Charlox29/Beetter/website/img/installation_2.png

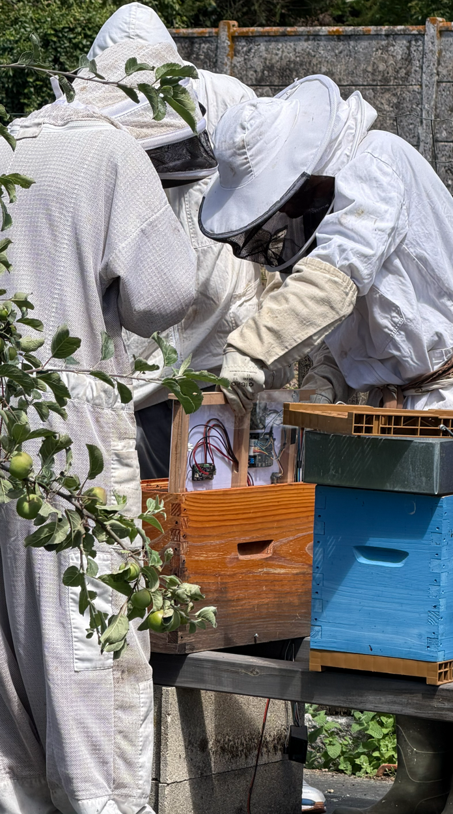
website/img/installation_2.png
