Charlox29/Beetter/website/img/installation_1.png

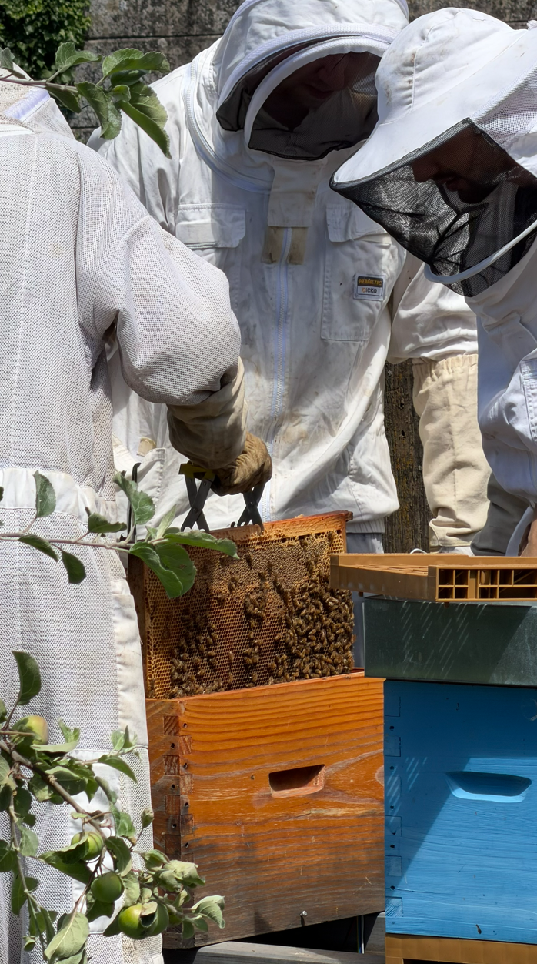
website/img/installation_1.png
