Charlox29/Beetter/website/docs/JDP_Affiche_Beetter_2026.pdf

– Une analyse interne et externe de la température, de l’hygrométrie, de la luminosité et de l’environnement sonore
– Un traitement intelligent des données grâce à différents modèles d’IA
– Une transmission longue distance
– Un stockage des données sur plusieurs mois/années
– Un système autonome en énergie

… donc voici notre solution.

# Système de Surveillance Apicole connecté

– La pollinisation assure 35 % du volume de la production agricole mondial
– La consommation mondiale de miel est de 1,8 à 2 millions de tonnes par an, se substituant aux sources de sucres classiques plus polluantes
– Une bonne pollinisation peut augmenter le nombre de fruits de 20 à 40 %, et permet de réduire de 25 % la quantité de fruits déformés

### Nos abeilles sont essentielles …

### Beetter Hive

– Le frelon asiatique les attaque
– Le décalage des saisons les perturbe
– Les événements météorologiques extrêmes comme les sécheresses prolongées
– Les visites physiques : Chaque ouverture de la ruche par l'apiculteur fait chuter la température interne, déchire la propolis et génère un stress thermique

### … mais elles sont en danger …

# Notre site

### Beetter Home

Promo E3 | AGUEH Thibault - AUCOUTURIER Charles - AZZA Anthony BERDUGO Simon - BOURGOIS Ethan

Suiveur :
FRANÇAIS Olivier
