Charlox29/Beetter/website/img/dash1en.png

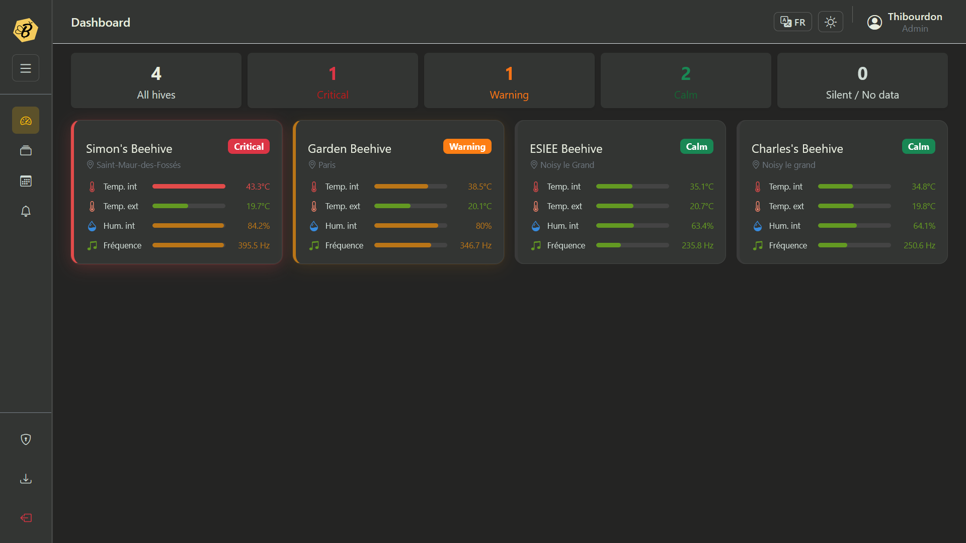
website/img/dash1en.png
