Charlox29/Beetter/website/img/dash1fr.png

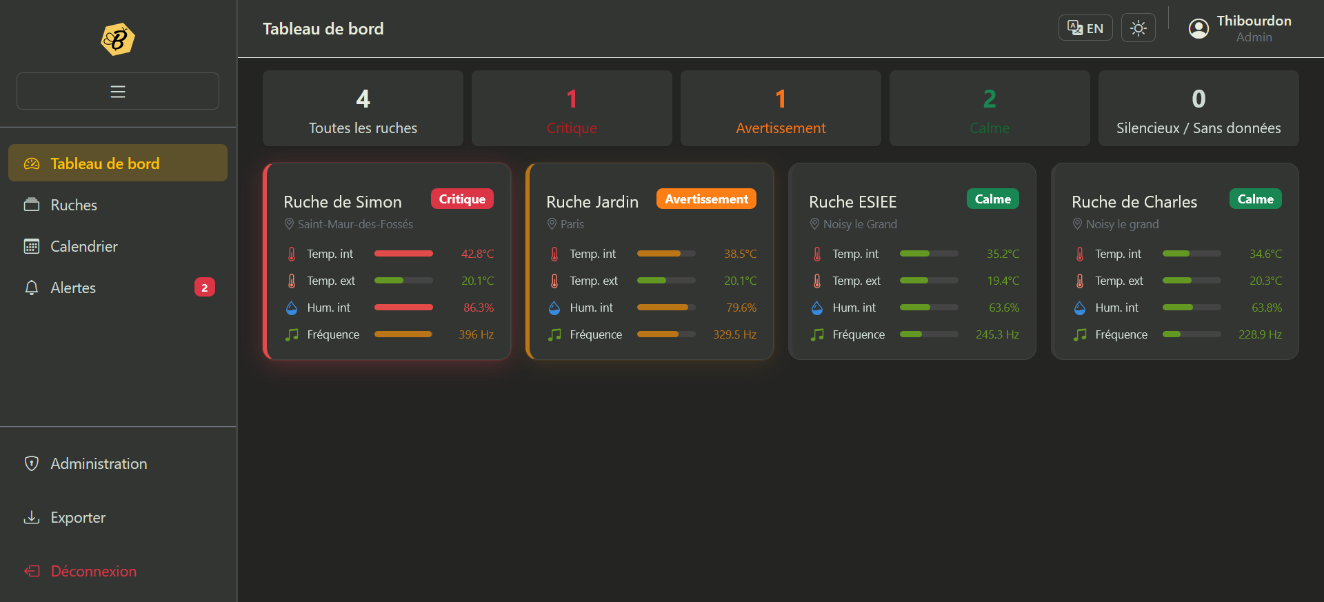
website/img/dash1fr.png
