Charlox29/Beetter/website/img/dash2en.png

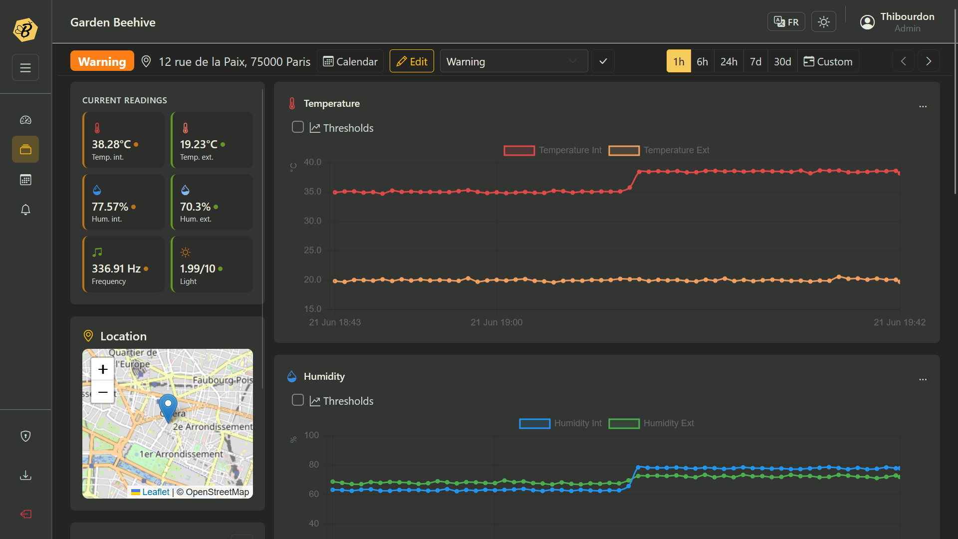
website/img/dash2en.png
