Charlox29/Beetter/website/img/dash2fr.png

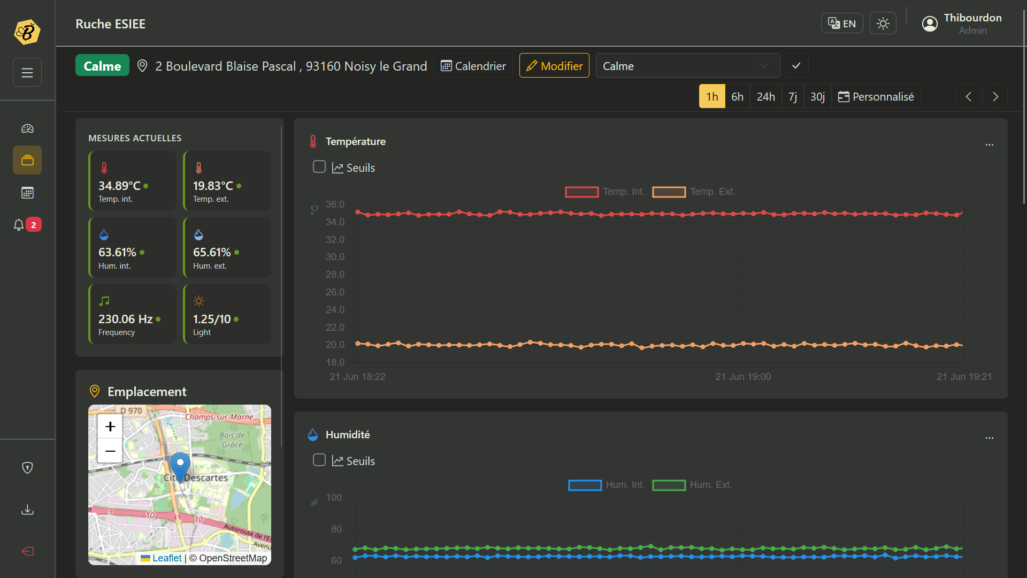
website/img/dash2fr.png
