Charlox29/Beetter/(commit log)

2026-05-26 fix : compose qui fait que ca fonctionne
2026-05-28 Update receiver.py
    rajout de l'adresse du raspberry pi
2026-05-29 ajout de nouvelles valeurs
2026-05-29 ajout de 2 données supplementaires dans influxDB
2026-06-01 feat : .patch actions :added sensors
2026-06-08 Fix : Dashboard filter + summary
2026-06-08 fix : éthique de merde
2026-06-15 Fix: 3000 hz of training -> 2000 hz
2026-06-15 docs: dashboard on kiosk (raspberry pi)
2026-06-15 feat : esp32 in firmware/
2026-06-15 Fix : un peu de tout
2026-06-16 fix : last firmware version
    [BeetterConfig.h, BeetterLoRa.cpp, BeetterLoRa.h, BeetterMic.cpp, BeetterMic.h, BeetterPhoto.h, BeetterSD.cpp, BeetterSD.h]
2026-06-16 feat : new name of bucket
2026-06-16 docs: align README with string beehive_id and 0-10 light scale
    Drop the stale beehive_id int-conversion note (ID is now a string
    end-to-end, matching beehives.id String(4)). Update light_ext
    examples/units from raw ADC to the 0-10 scale.
2026-06-16 IA : Claude things to wire everything together
2026-06-16 feat-fix-docs: firmware
    - SD vérifiée à chaque cycle — si la carte est retirée à chaud, beginCycle() le détecte, désactive les écritures et affiche un warning sans bloquer les mesures ni le LoRa
    - Nom WAV horodaté — /wav/B001_20260616_132700.wav (avec les secondes) au lieu du numéro de cycle, plus de doublon après redémarrage
    - BLE désactivé — économise ~15 mA et de la mémoire RAM
    - commentaires et readme à jour
    [BeetterConfig.h, BeetterLoRa.h, BeetterMic.cpp, BeetterMic.h, BeetterSD.cpp, BeetterWAV.cpp, BeetterWAV.h, Beetter_Main.ino]
2026-06-17 fix: firmware lora + watchdog update
    [BeetterConfig.h, BeetterLoRa.cpp, BeetterLoRa.h, BeetterMic.cpp, BeetterMic.h, Beetter_Main.ino]
2026-06-21 feat : mfcc export and custom data filter
2026-06-23 feat: register multiple local instances on server, track push status per instance
2026-06-24 feat : bucket anomaly and inference
2026-06-24 fix: hostname InfluxDB hors-Docker et pivot Flux incorrects dans inference_worker
    hostname : le --env par défaut pointait vers app/.env (influxdb:8086, nom de service Docker) au lieu du .env racine (localhost:8086)
    pivot Flux : columnKey: ["_field"] → columnKey: ["_measurement"] pour correspondre au schéma d'écriture de Flask
