Charlox29/Beetter/(notices)

Notices in the files:
README.md:
License: MIT
